HexabitzPlatform/H15R0x-Hardware/README.md

# H15R0x-Hardware
Hexabitz Bipolar +/-10V Analog Output Module Hardware Design
