HexabitzPlatform/H15R0x-Hardware/Released/BOM/H15R00.xlsx

Qty | Comment | Designator | Description | MFN | MPN | OCTOPART_URL | Qty
5 | 100nF 10V | C3, C5, C6, C8, C9 | CAP CER 10% X7R 0603 | KEMET | C0603C104K8RACTU | https://octopart.com/c0603c104k8ractu-kemet-145075?r=sp&s=9bS9ASSwSEqMCE9KBEQZ0g
2 | 100nF 25V | C10, C11 | CAP CER 10% X7R 0603 | Murata | GRM188R71E104KA01D | https://octopart.com/grm188r71e104ka01d-murata-196239?r=sp&s=9Sa0iYM-THq9pjXKXbxryA
1 | 1.00uF | C2 | CAP CER 1UF 16V X7R 0805 | Yageo | CC0805KKX7R7BB105 | https://octopart.com/cc0805kkx7r7bb105-yageo-8376555?r=sp&s=YKl1wwtkROau_X5nniH2ig
2 | 4.7uF | C4, C7 | CAP CER 4.7UF 25V X6S 0805 | Murata | GRM21BC81E475KA12L | https://octopart.com/grm21bc81e475ka12l-murata-10331911?r=sp&s=RY3qZSD8T6mG6TC9CHI5qQ
1 | 10nF | C1 | CAP CER 10% X7R 0603 | KEMET | C0603C103K5RACTU | https://octopart.com/c0603c103k5ractu-kemet-133094?r=sp&s=R_iPBxLnSmGqhkU2rIMFpg
2 | 10pF 50V | C14, C15 | CAP CER 10% X7R 0603 | Murata | GRM1885C1H100JA01D | https://octopart.com/grm1885c1h100ja01d-murata-196121?r=sp&s=M0doikvzQymn4ajEe0ihSw
2 | 100pF 50V | C12, C13 | CAP CER 10% X7R 0603 | Avx | 06035A101JAT2A | https://octopart.com/06035a101jat2a-avx-55386344?r=sp&s=OWJQ2Zm8S2q0g8RSQtFoSw
1 | 150pF 50V | C17 | CAP CER 10% X7R 0603 | TDK | C1608C0G1H151F080AA | https://octopart.com/c1608c0g1h151f080aa-tdk-26013419?r=sp&s=gUiTfpbJT1mAyA8NJ0XI8Q
1 | 20nF 50V | C16 | Cap Ceramic 0.02uF 50V X7R 10% SMD 0603 125°C Paper T/R | Samsung | CL10B203KB8NNNC | https://octopart.com/cl10b203kb8nnnc-samsung-19831635?r=sp&s=OBY_pk9VR_mJ3Hxg4Ft1_g
1 | VLMS1300-GS08 | D1 | Red 0603 130Â° Clear 54 mcd 2 V Surface Mount ChipLED ; | Vishay | VLMS1300-GS08 | https://octopart.com/vlms1300-gs08-vishay-21709201?r=sp&s=_gcP4_q8T1SC6PJQPTQ9yA
4 | MMZ1608Y300B | FB1 | Ferrite Beads Multi-Layer 30Ohm 25% 100MHz 1.5A 50mOhm DCR 0603 | TDK | MMZ1608Y300B | https://octopart.com/mmz1608y300b-tdk-368280?r=sp&s=cd9_2ZEqQ9q9UNBuQgHAiA
1 | Analog Output | AO | Terminal Block 10 A 160 V 3.5 mm 26 to 16 AWG 2 Screw Solder 2.5 kV PA | Phoenix Contact | 1751248 | https://octopart.com/1751248-phoenix+contact-31334?r=sp&s=dfbEyNHiQNetUL69ahOrPQ
1 | Analog Power | PWR | Terminal Block 10 A 160 V 3.5 mm 26 to 16 AWG 3 Screw Solder 2.5 kV PA | Phoenix Contact | 1751251 | https://octopart.com/1751251-phoenix+contact-36473?r=sp&s=9M0VWNoHTyq04j3qI6lQOQ
1 | 270.0R | R1 | Thick Film Resistors - SMD 0603 | Yageo | RC0603FR-07270RL | https://octopart.com/search?q=RC0603FR-07270RL&start=0
1 | 0.0R | R2 | Thick Film Resistors - SMD 0603 | Yageo | RC0603JR-070RL | https://octopart.com/rc0603jr-070rl-yageo-1241539?r=sp&s=X2NteqRjRNWrnx42Y0aliA
1 | 10.0K | R3 | Thick Film Resistors - SMD 0603 | Yageo | RC0603JR-0710KL | https://octopart.com/search?q=RC0603JR-0710KL&start=0
1 | 71.5R 1% | R4 | Thick Film Resistors - SMD 0603 | Panasonic | ERJ-3EKF71R5V | https://octopart.com/erj-3ekf71r5v-panasonic-55421901?r=sp&s=JXFkVIq0Td2PcEUj2-UrKA
1 | 24.9K 0.1% | R5 | Thick Film Resistors - SMD 0603 | Panasonic | ERA-3AEB2492V | https://octopart.com/era-3aeb2492v-panasonic-14412272?r=sp&s=tIguNO2DQ02PU7gq6_vEIQ
1 | 8.25K 0.1% | R6 | Thick Film Resistors - SMD 0603 | Panasonic | ERA-3AEB8251V | https://octopart.com/era-3aeb8251v-panasonic-55477301?r=sp&s=p46abNa6QO-wGnrush-PUA
1 | 12.4K 0.1% | R7 | Thick Film Resistors - SMD 0603 | Panasonic | ERA-3AEB1242V | https://octopart.com/era-3aeb1242v-panasonic-55639351?r=sp&s=K0xQjqOwSGaT1tqbXnh0hg
1 | STM32F091CBU6 | U1 | MCU 32-bit ARM Cortex M0 RISC 128KB Flash 2.5V/3.3V 48-Pin UFQFPN EP Frame | STMicroelectronics | STM32F091CBU6 | https://octopart.com/stm32f091cbu6-stmicroelectronics-51988677?r=sp&s=bU6fpgsrTZOxHyt7jkfh3w
1 | OPA188AIDBVR | U2 | Precision, Low-Noise, Rail-to-Rail Output, 36V Zero-Drift Operational Amplifier 5-SOT-23 -40 to 125 | Texas Instruments | OPA188AIDBVR | https://octopart.com/opa188aidbvr-texas+instruments-27810397?r=sp&s=zwpAzK6tSwu39ID1-8lLKg
1 | XTALL_CSTCE8M00G52 | X1 | MURATA CSTCE8M00G52-R0 RESONATOR, SMD, 8MHZ ; | Murata | CSTCE8M00G52Z-R0 | https://octopart.com/cstce8m00g52z-r0-murata-17755941?r=sp&s=JDnNJnrHQhyS8Zk4ofFWXw
