HexabitzPlatform/H15R0x-Hardware/Documentation/H15R00 Schematics.pdf

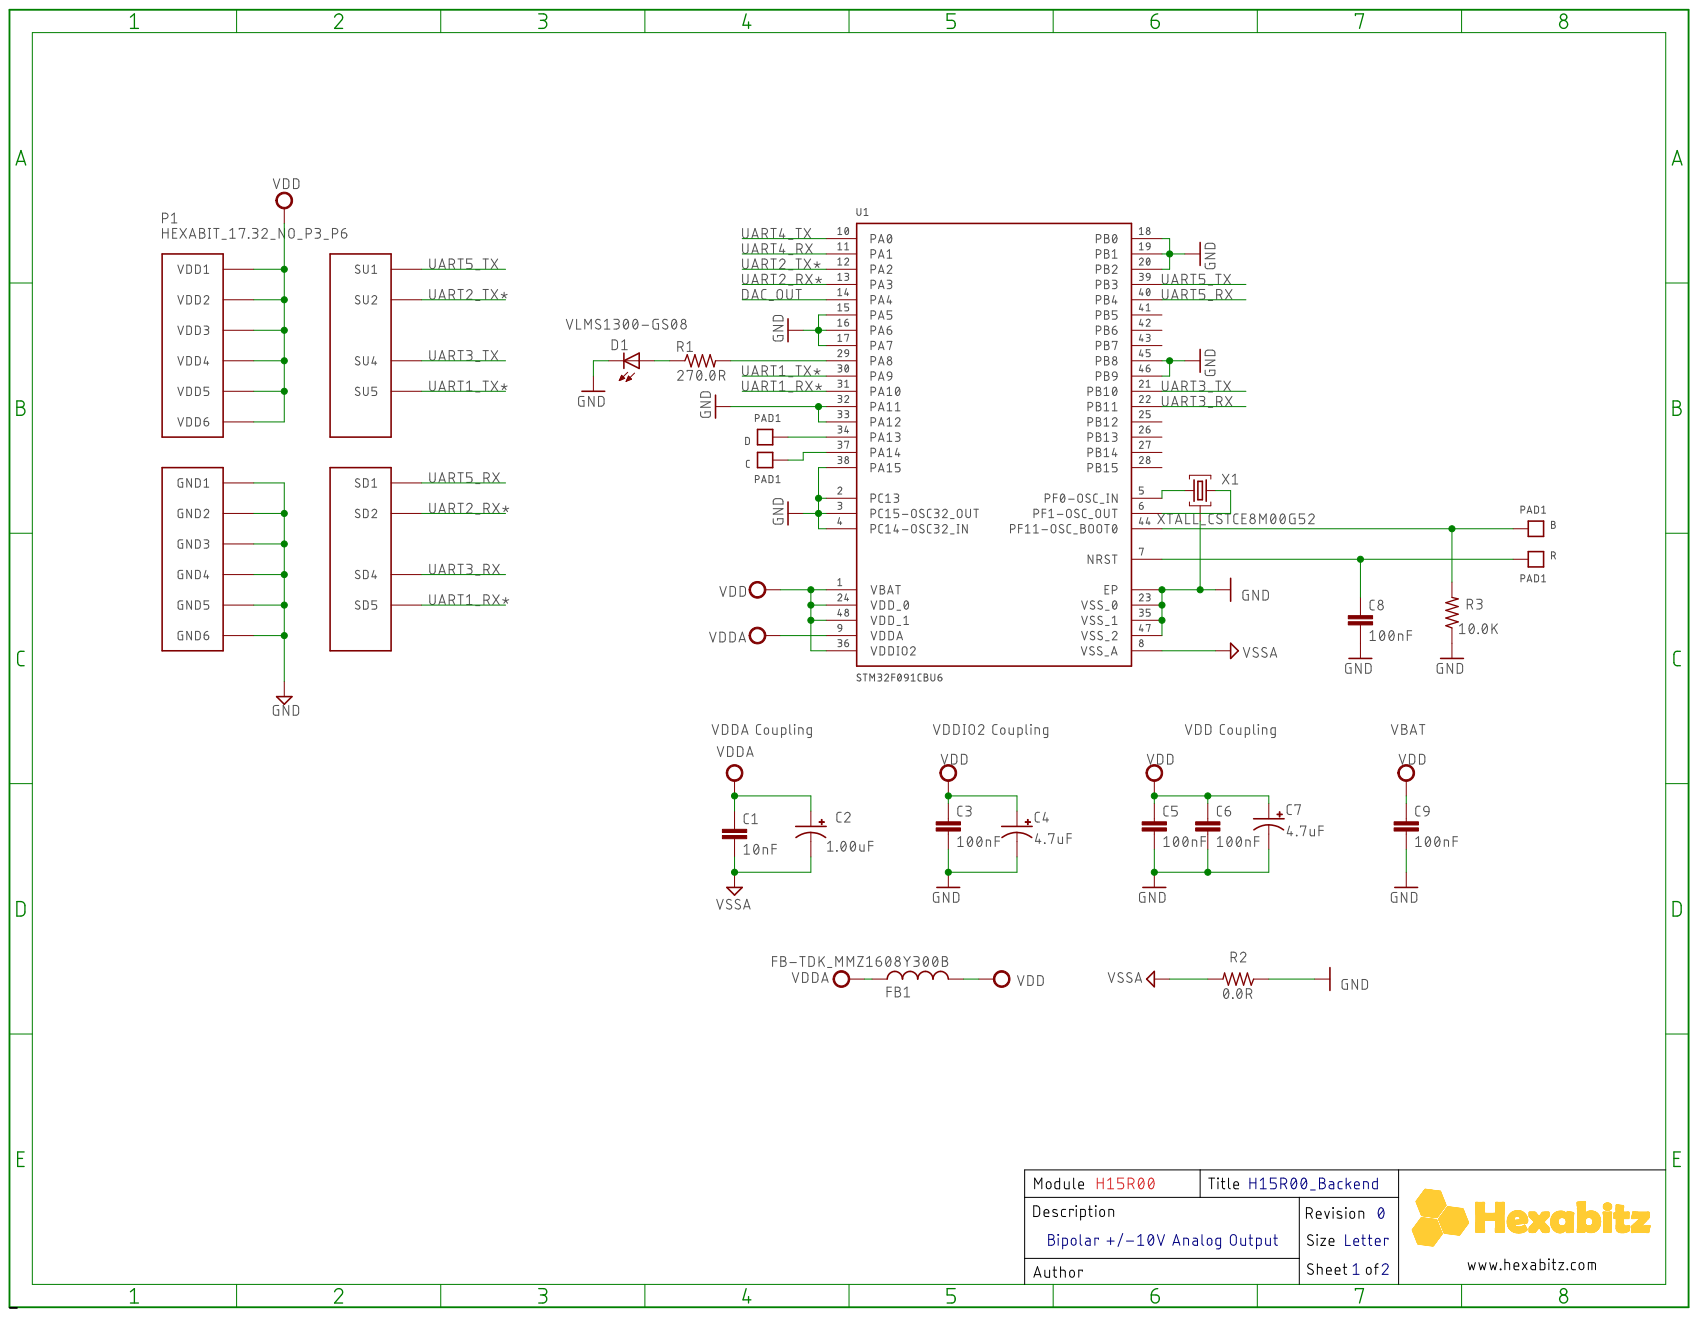
[picture p1: page 1]

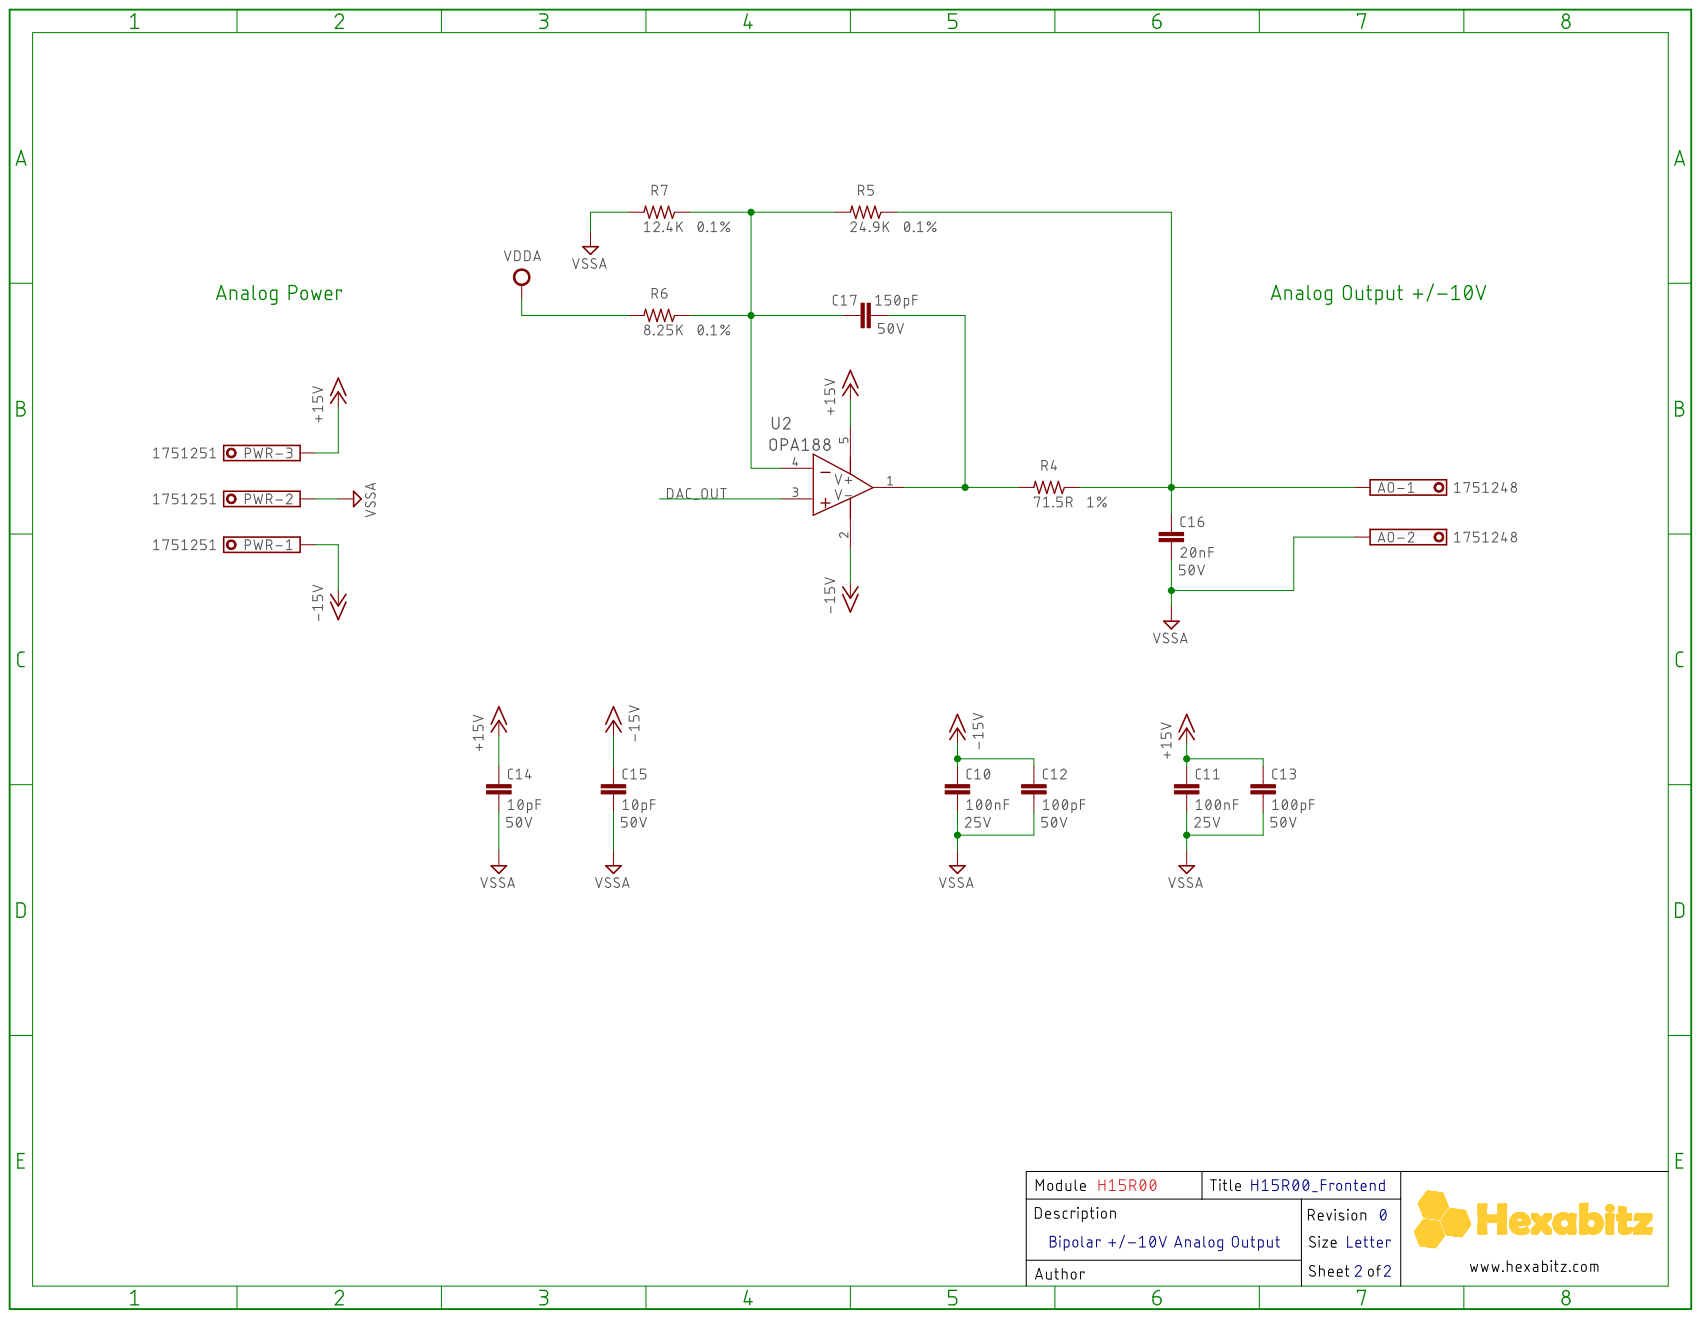
[picture p2: page 2]
