HexabitzPlatform/H15R0x-Hardware/Design/H15R00.brd

## EAGLE design Design/H15R00.brd (2019-12-16)

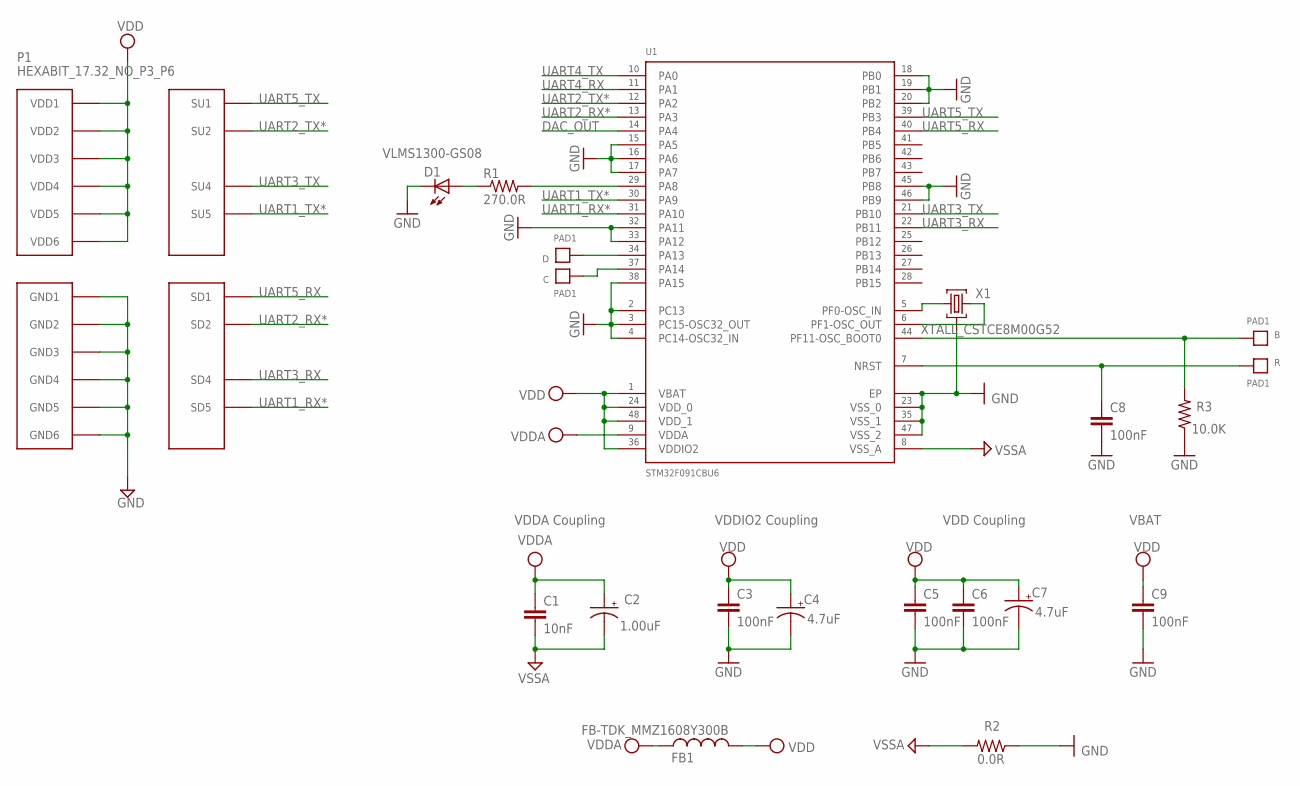
[picture p3: schematic H15R00.sch, sheet 1]

Parts:
B: PAD1
C: PAD1
C1: 10nF; C-0603; TOLERANCE 10%; VOLTAGE_RATING 50V; MPN C0603C103K5RACTU
C2: 1.00uF; C-0805-POL; TOLERANCE 10%; VOLTAGE_RATING 16V; MPN CC0805KKX7R7BB105
C3, C6, C8: 100nF; C-0603; TOLERANCE 10%; VOLTAGE_RATING 10V; MPN C0603C104K8RACTU
C4, C7: 4.7uF; C-0805-POL; TOLERANCE 10%; VOLTAGE_RATING 25V; MPN GRM21BC81E475KA12L
C5: 100nF; C-0603; TOLERANCE 10%; VOLTAGE_RATING 10; MPN C0603C104K8RACTU
C9: 100nF; C-0603; TOLERANCE 10V; VOLTAGE_RATING 10%; MPN C0603C104K8RACTU
D: PAD1
D1: VLMS1300-GS08; MPN VLMS1300-GS08
FB1: FB-TDK_MMZ1608Y300B; MPN MMZ1608Y300B
P1: HEXABIT_17.32_NO_P3_P6
R: PAD1
R1: 270.0R; R-0603; TOLERANCE 1%; MPN RC0603FR-07270RL
R2: 0.0R; R-0603; MPN RC0603JR-070RL
R3: 10.0K; R-0603; TOLERANCE 5%; MPN RC0603JR-0710KL
U1: STM32F091CBU6
X1: XTALL_CSTCE8M00G52

Connections:
B1: B.P$1, B.P$2, R3.2, U1.P$44 (PF11-OSC_BOOT0)
DAC_OUT: U1.P$14 (PA4); also elsewhere on the board
GND: C3.2, C4.2 (-), C5.2, C6.2, C7.2 (-), C8.2, C9.2, D1.C, P1.PAD_PD7 (GND1), P1.PAD_PD8 (GND2), P1.PAD_PD9 (GND3), P1.PAD_PD10 (GND4), P1.PAD_PD11 (GND5), P1.PAD_PD12 (GND6), R2.1, R3.1, U1.EP, U1.P$2 (PC13), U1.P$3 (PC14-OSC32_IN), U1.P$4 (PC15-OSC32_OUT), U1.P$15 (PA5), U1.P$16 (PA6), U1.P$17 (PA7), U1.P$18 (PB0), U1.P$19 (PB1), U1.P$20 (PB2), U1.P$23 (VSS_0), U1.P$32 (PA11), U1.P$33 (PA12), U1.P$35 (VSS_1), U1.P$38 (PA15), U1.P$45 (PB8), U1.P$46 (PB9), U1.P$47 (VSS_2), X1.P$2 (2)
unnamed: R1.2, U1.P$29 (PA8)
unnamed: D1.A, R1.1
unnamed: U1.P$5 (PF0-OSC_IN), X1.P$1 (1)
unnamed: U1.P$6 (PF1-OSC_OUT), X1.P$3 (3)
unnamed: D.P$1, D.P$2, U1.P$34 (PA13)
unnamed: C.P$1, C.P$2, U1.P$37 (PA14)
R1: C8.1, R.P$1, R.P$2, U1.P$7 (NRST)
UART1_RX*: P1.PAD_PD5 (SD5), U1.P$31 (PA10)
UART1_TX*: P1.PAD_PU5 (SU5), U1.P$30 (PA9)
UART2_RX*: P1.PAD_PD2 (SD2), U1.P$13 (PA3)
UART2_TX*: P1.PAD_PU2 (SU2), U1.P$12 (PA2)
UART3_RX: P1.PAD_PD4 (SD4), U1.P$22 (PB11)
UART3_TX: P1.PAD_PU4 (SU4), U1.P$21 (PB10)
UART4_RX: U1.P$11 (PA1)
UART4_TX: U1.P$10 (PA0)
UART5_RX: P1.PAD_PD1 (SD1), U1.P$40 (PB4)
UART5_TX: P1.PAD_PU1 (SU1), U1.P$39 (PB3)
VDD: C3.1, C4.1 (+), C5.1, C6.1, C7.1 (+), C9.1, FB1.2, P1.PAD_PU7 (VDD1), P1.PAD_PU8 (VDD2), P1.PAD_PU9 (VDD3), P1.PAD_PU10 (VDD4), P1.PAD_PU11 (VDD5), P1.PAD_PU12 (VDD6), U1.P$1 (VBAT), U1.P$24 (VDD_0), U1.P$36 (VDDIO2), U1.P$48 (VDD_1)
VDDA: C1.1, C2.1 (+), FB1.1, U1.P$9 (VDDA); also elsewhere on the board
VSSA: C1.2, C2.2 (-), R2.2, U1.P$8 (VSS_A); also elsewhere on the board

Notes on the sheet:
VDDA Coupling
VDDIO2 Coupling
VDD Coupling
VBAT

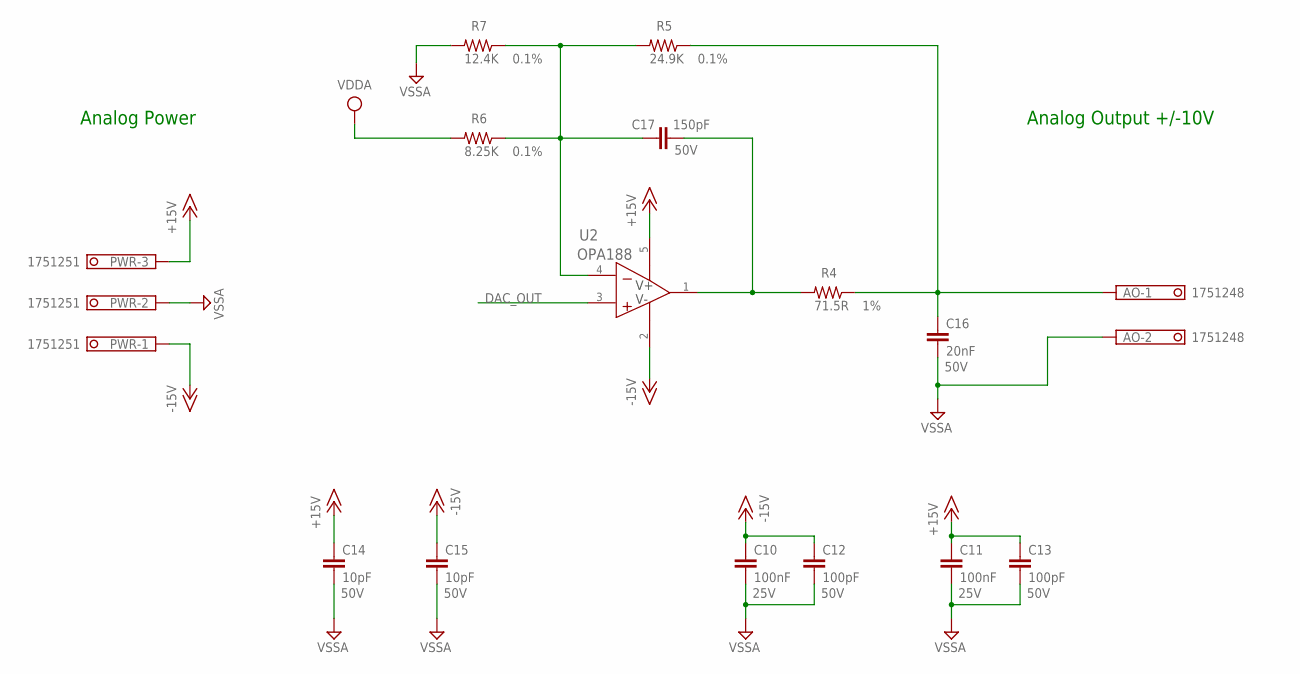
[picture p4: schematic H15R00.sch, sheet 2]

Parts:
AO: 1751248; CON-PHOENIX-350_1751248; MPN 1751248
C10, C11: 100nF; C-0603; TOLERANCE 10%; VOLTAGE_RATING 25V; MPN GRM188R71E104KA01D
C12, C13: 100pF; C-0603; TOLERANCE 5%; VOLTAGE_RATING 50V; MPN 06035A101JAT2A
C14, C15: 10pF; C-0603; TOLERANCE 5%; VOLTAGE_RATING 50V; MPN GRM1885C1H100JA01D
C16: 20nF; C-0603; TOLERANCE 10%; VOLTAGE_RATING 50V; MPN CL10B203KB8NNNC
C17: 150pF; C-0603; TOLERANCE 1%; VOLTAGE_RATING 50V; MPN C1608C0G1H151F080AA
PWR: 1751251; MPN 1751251
R4: 71.5R; R-0603; TOLERANCE 1%; MPN ERJ-3EKF71R5V
R5: 24.9K; R-0603; TOLERANCE 0.1%; MPN ERA-3AEB2492V
R6: 8.25K; R-0603; TOLERANCE 0.1%; MPN ERA-3AEB8251V
R7: 12.4K; R-0603; TOLERANCE 0.1%; MPN ERA-3AEB1242V
U2: OPA188; DBV0005A_N

Connections:
+15V: C11.1, C13.1, C14.1, PWR.3, U2.5 (V+)
-15V: C10.1, C12.1, C15.1, PWR.1, U2.2 (V-)
DAC_OUT: U2.3 (IN+); also elsewhere on the board
unnamed: AO.1, C16.1, R4.1, R5.1
unnamed: C17.2, R4.2, U2.1 (OUT)
unnamed: C17.1, R5.2, R6.1, R7.1, U2.4 (IN-)
VDDA: R6.2; also elsewhere on the board
VSSA: AO.2, C10.2, C11.2, C12.2, C13.2, C14.2, C15.2, C16.2, PWR.2, R7.2; also elsewhere on the board

Notes on the sheet:
Analog Output +/-10V
Analog Power

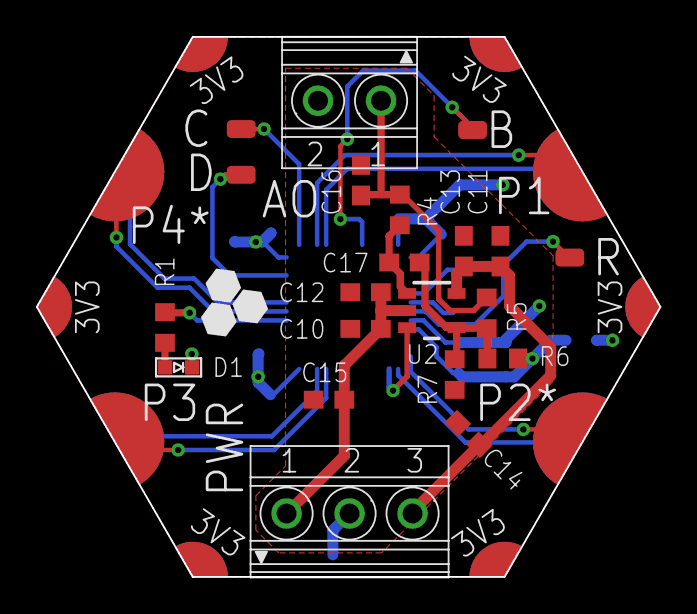
[picture p5: board H15R00.brd from above]

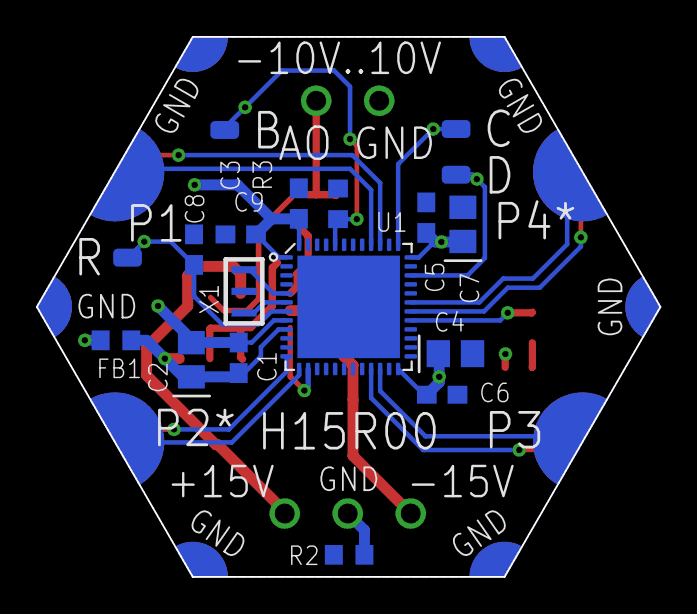
[picture p6: board H15R00.brd from below]

Board: 2 copper layers, 34.6 x 30.0 mm, 36 parts (14 on the bottom side), 26 nets.
