HexabitzPlatform/H15R0x-Hardware/(commit log)

2019-12-13 Generated seed files from the script
    [H15R00.brd, H15R00.sch]
2019-12-13 Finished schematics
    [H15R00.brd, H15R00.sch]
2019-12-16 Placed all components Routed analog part and most digital Added VSSA polygon
    [H15R00.brd, H15R00.sch]
2019-12-16 Finished routing and silkscreen
    [H15R00.brd, H15R00.sch]
2019-12-16 Solved DRC Generated gerber, drill, pick n place and schematics Generated BOM First release Ver 0
    [H15R00.brd, H15R00.sch, H15R00.xlsx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]
2020-05-09 Fix BOM
    [H15R00.xlsx]
